Aftakaalovesavocado/FloodGuard-Village/sim/simulasi_testbed.html

# FGV Testbed Simulator · FloodGuard Village · SOBAT Competition 2026

Hal. 2: Multi-Node →

engine check…

STATUS SIMPUL

AMAN

RISK LEVEL

5.0

LEVEL TAMPUNGAN45.0 %

DEBIT LEWAT NODE10.0 L/mnt

INDEKS DEBIT I_Q1.00

PRAKIRAAN HUJAN tp0.2 mm/3j

RULE MENYALA4 / 27

ESTIMASI MELUAP— stabil

⚠ LANTAI KESELAMATAN AKTIF — kondisi fisik tidak dinegosiasikan bobot fuzzy

RIWAYAT LEVEL (%) — jendela 6 menit

KONTROL TESTBED

Ball valve (debit pompa) 59 %

Gate outlet (sumbatan) 100 %

Injeksi prakiraan hujan (tp BMKG) 0.2 mm/3j

SEKENARIO UJI (PADA SIMPUL INI)

S1 Baseline S2 Prakiraan Hujan S3 Debit Puncak S4 Sumbatan S5 Hujan Lokal S6 Kritis

WAKTU SIMULASI

⏸ Jeda t = 0:00 TX LoRa seq 0

Ket. kejujuran: logika inferensi (MF, 27 rule Sugeno, lapisan keselamatan, estimator least-squares) adalah port 1:1 dari sim/fgv_engine.py v2 — dibuktikan self-test … vektor di halaman ini. Dinamika hidrolika tampungan adalah model first-order untuk visualisasi demo (bukan solusi numerik Manning). Klaim yang sah dari halaman ini: disimulasikan.
