Aftakaalovesavocado/FloodGuard-Village/sim/testbed_kaskade.html

# FGV Testbed Kaskade Bertingkat — simulasi konsep (v2)

3 tingkat (30/20/10 cm) · pipa custom 40×20 mm · tampungan + stilling well · sirkulasi tertutup · proporsi disesuaikan agar terbaca, bukan skala persis

S1 · Normal S2 · Hujan (injeksi BMKG) S3 · Banjir kiriman S4 · Sumbatan hilir S5 · Banjir lokal

S1 · AMAN — kondisi baseline; semua gate normal, valve 50%. Data run ini dipakai menetapkan Q_ref per node.

### Parameter operasi (hasil hitung Manning)

Pipa custom | 40 × 20 mm, 30 cm/tingkat, S = 1%
Kapasitas pipa (full) | 22.3 L/menit @ S=1% (15.8 @ S=0.5%)
Q operasi (valve) | 5 – 15 L/menit → air 35–82% tinggi pipa
Kedalaman di pipa | 7–16 mm → terlalu dangkal untuk JSN (±10 mm)
Level sistem | JSN + stilling well di tampungan (chan 120 mm)
Residence time tampungan | 12–36 detik (gelombang terlihat merambat)
Ruang vertikal sensor | ±25 cm → susunan tangga, tampungan di tepi luar

### Kenapa beberapa keputusan diubah dari konsep awal

- Sensor pindah ke atas tampungan — beam JSN ±30° membentuk lingkaran pantulan Ø≈46 cm pada jarak 23 cm, lebih lebar dari pipa (30 cm) → echo dinding. Stilling well PVC 2" memandu beam + meredam riak.
- Susunan tangga, bukan tumpuk lurus — stilling well butuh ±25 cm ruang vertikal; jarak antar dek 10 cm tidak cukup kalau sensor berada di bawah dek atas.
- Kemiringan pipa 1% — di 0.5% pipa 20 mm penuh pada Q≈16 L/menit → aliran surcharged, Manning tidak berlaku.
- Gate di outlet tampungan — menaikkan muka air (40–120 mm) sekaligus jadi saklar skenario sumbatan.
